MarionJaud/POSEIDONsystem/POSEIDON.png

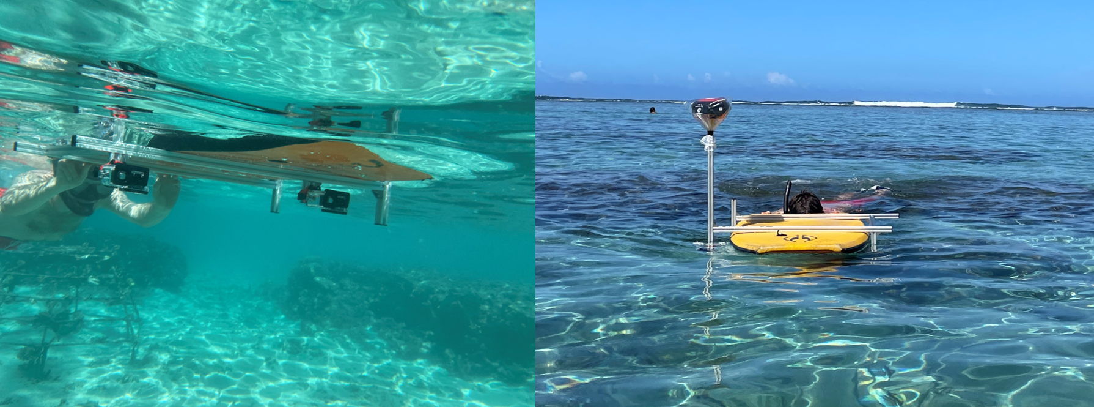
POSEIDON.png
