MarionJaud/POSEIDONsystem/DIY_POSEIDON.pdf

Auteur : Marion Jaud (IUEM, CNRS) | mise à jour : juin 2025

1

## Liste du matériel pour la fabrication du système POSEIDON

- GPS Centipède | ~ 600 € | x 1
- GoPro (https://gopro.com/fr/fr/shop/cameras/hero10-black/CHDHX-101-master.html) x 2 | 370 € | x 2
- cartes micro-SD (https://www.fnac.com/Carte-Memoire-SanDisk-Ultra-Plus-MicroSDXC-UHS-I-128-Go-avec-Adaptateur-microSD-microSDHC-et-microSDXC/a13907563/w-4) 128 Go x 2 | 30 € | x 2
- Facultatif : Boitiers de protection GoPro (https://gopro.com/fr/fr/shop/mounts-accessories/protective-housing-plus-waterproof-case/ADDIV-001.html) x 2 | 50 € | x 2
- BodyBoard (https://www.decathlon.fr/p/bodyboard-100-avec-leash-poignet/_/R-p-311496?mc=8557126&c=BLEU_TURQUOISE) | 35 € | x 1
- Profilés alu 20mm x 20mm x 2000 mm (https://fr.rs-online.com/web/p/tubes-et-profiles-de-structures/2123293/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) (x 3) | 30.25 € HT | x 3
- visserie associée aux profilés alu :
- Equerres de fixation, profilé 20 mm, L. 20mm, filetage M4, rainure 6mm (https://fr.rs-online.com/web/p/raccords-pour-elements-de-structure/2367192/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) (x 20 => 2 sachets)
| 11.89 € HT | x 2
- Ecrou à rainure en T, profilé 20 mm, filetage M4, rainure 6mm (https://fr.rs-online.com/web/p/raccords-pour-elements-de-structure/4667281) (x 40 => 4 sachets de 10)
| 9.79 € HT | x 4
- Capuchons, profilé de 20 mm (https://fr.rs-online.com/web/p/embouts-et-bouchons/4667247/?searchHistory=%7B%22enabled%22%3Atrue%7D) (x 10 => 1 sachet) | 9.91 € HT | x 1
- Vis 6 pans à tête bombée hexagonale, M4 x 8mm, en Acier Inoxydable (https://fr.rs-online.com/web/p/vis-a-six-pans/2328170) (x 40 => 1 boîte 50)
| 10.21 € HT | x 1
- Vis 6 pans à tête bombée hexagonale, M4 x 10mm, en Acier Inoxydable (https://fr.rs-online.com/web/p/vis-a-six-pans/2328186) (x 4 => 1 boîte 50)
| 12.83 € HT | x 1
- Rondelles, M4, Acier inoxydable (https://fr.rs-online.com/web/p/rondelles/189636) | 6.05 € HT | x 1
- support montage antenne GPS sur profilé alu 20 mm x 20 mm
=> impression 3D (entretoise_GPS v5.stl)
- support (x 2) montage GoPro sur profilé alu 20 mm x 20 mm
=> impression 3D (GoPro_Mount_V2.stl)
TOTAL : | ~ 1730 €

## Assemblage de la plateforme POSEIDON

- 1 profilé de 60 cm (A)
- 3 profilé de 40 cm (B)
- 3 profilés de 20 cm (C)
- 4 profilés de 65 cm (D)
- 2 profilés de 8 cm (E)
NB : les tailles sont données à titre indicatif et peuvent être adaptées au support flottant !
- support montage antenne GPS entretoise_GPS v5.stl (F)
- support (x 2) montage GoPro GoPro_Mount_V2.stl (G)

Assembler la structure en profilés aluminium au moyen des équerres, rondelles et boulons comme indiqué sur le plan ci-après. Pour limiter les risques de blessures, ajouter des embouts capuchons aux extrémités apparentes des profilés.

Emboiter et visser le support d’antenne GNSS au sommet du mat.

Visser les supports des caissons GoPro sur les profilés (E1) et (E2).

Auteur : Marion Jaud (IUEM, CNRS) | mise à jour : juin 2025

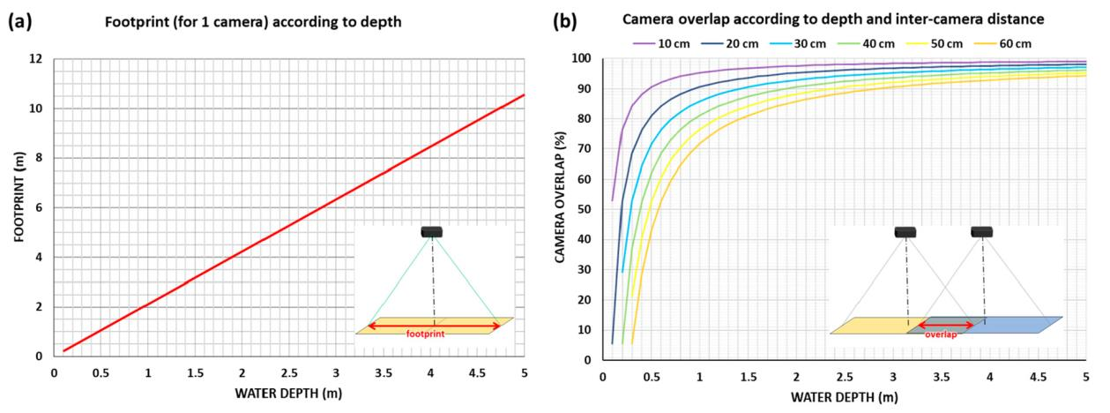
[picture p2: figure]
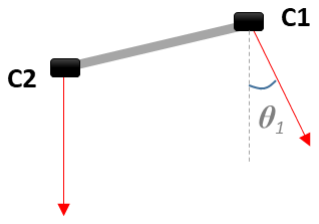
[picture p3: figure]

2

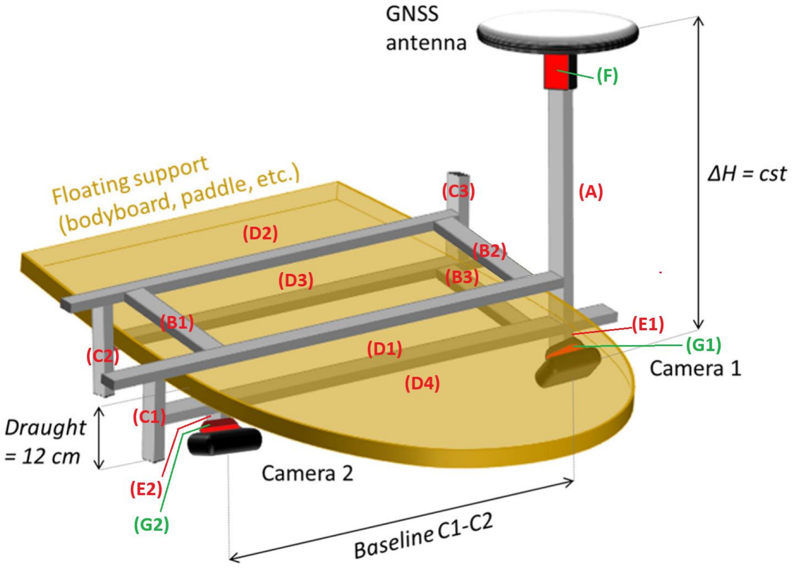
[picture p4: figure]

Les dimensions de la structure sont ajustables (dans une certaine mesure) en dévissant légèrement les équerres et en faisant coulisser les profilés.

La structure est maintenue fixe sur le support flottant en le prenant en étau selon la verticale.

La distance entre les caméras peut être ajustée en faisant coulisser le profilé (E2). Plus la profondeur est faible, plus les caméras doivent être proches.

Pour diversifier les angles de prise de vue, il est recommandé de dépointer l’une des caméras de 20 à 30°.
