MarionJaud/POSEIDONsystem/GoPro_Mount_V2.stl

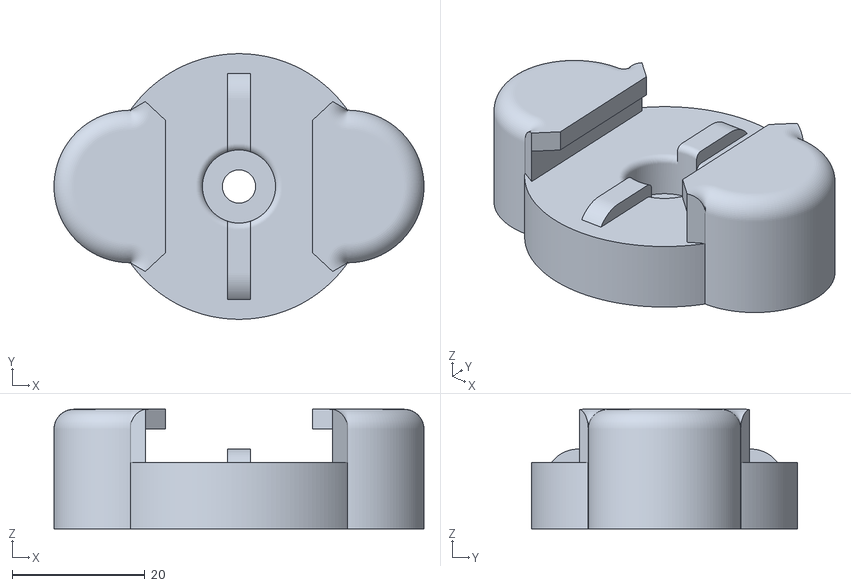
[picture p5: CAD file, 2025-12-04]
GoPro_Mount_V2.stl
55.7 x 40.0 x 18.0
