MarionJaud/POSEIDONsystem/entretoise_GPS v5.stl

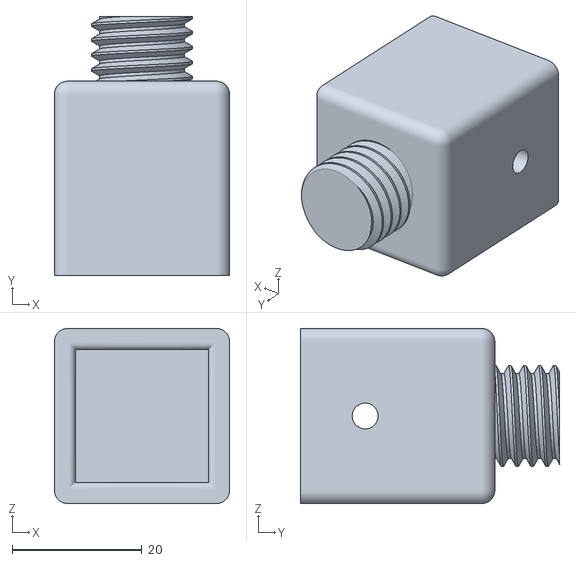
[picture p6: CAD file, 2025-12-04]
entretoise_GPS v5.stl
27.0 x 40.0 x 27.0
